ramunecyudokusha/ARSTM-2602/CYW43439KUBGT/SG-XFWLB-63-800.step

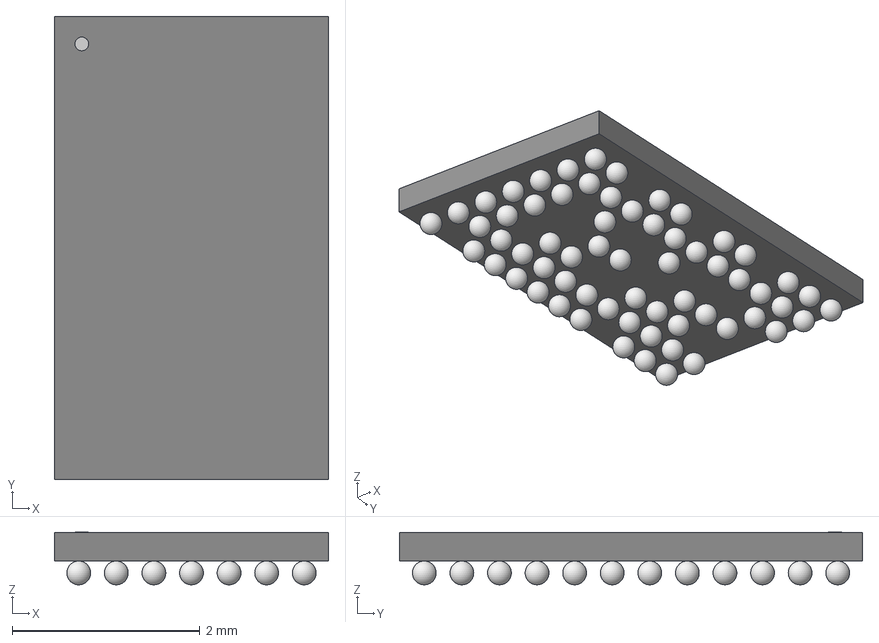
[picture p1: CAD file, 2026-05-24]
CYW43439KUBGT/SG-XFWLB-63-800.step
2.92 x 4.93 x 0.561 mm
