ramunecyudokusha/ARSTM-2602/kiban.step

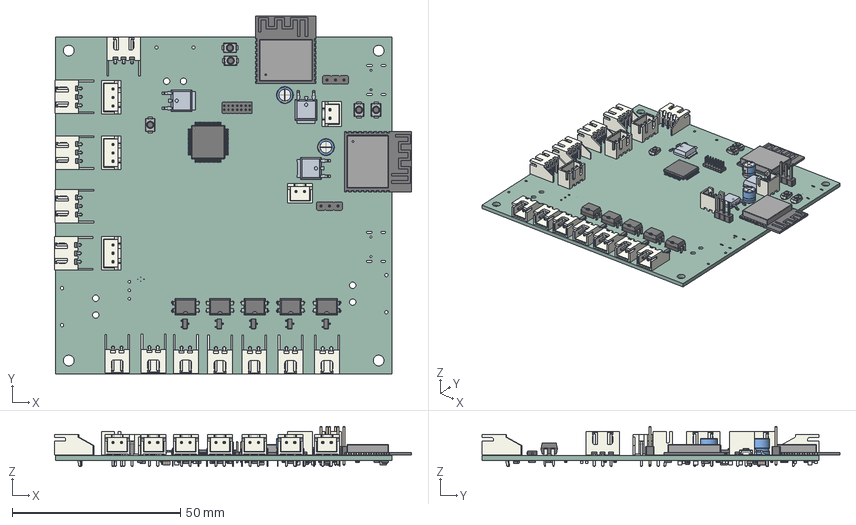
[picture p2: CAD file, 2026-08-06]
kiban.step
106.1 x 106.3 x 11.9 mm
JST_XH_S3B-XH-A-1_1x03_P2.50mm_Horizontal x 5
PinHeader_2x07_P1.27mm_Vertical
kiban 1.3.1 x 3
JST_XH_B3B-XH-A_1x03_P2.50mm_Vertical x 3
SW_Push_SPST_NO_Alps_SKRK x 5
CP_Radial_D5.0mm_P2.00mm x 2
JST_XH_B2B-XH-A_1x02_P2.50mm_Vertical x 2
SOT-23 x 5
DIP-4_W7.62mm x 5
ESP32-C3-WROOM-02 x 2
PinHeader_1x03_P2.54mm_Vertical x 2
JST_XH_S2B-XH-A-1_1x02_P2.50mm_Horizontal x 7
LQFP-64_10x10mm_P0.5mm
R_0603_1608Metric x 10
C_0603_1608Metric x 14
R_0805_2012Metric x 16
C_0805_2012Metric x 10
D_SOD-323F x 5
D_SOD-323 x 3
ARSTM2602_PCB
