ramunecyudokusha/ARSTM-2602/TCAN3414DRBR/TCAN3414DRBR.step

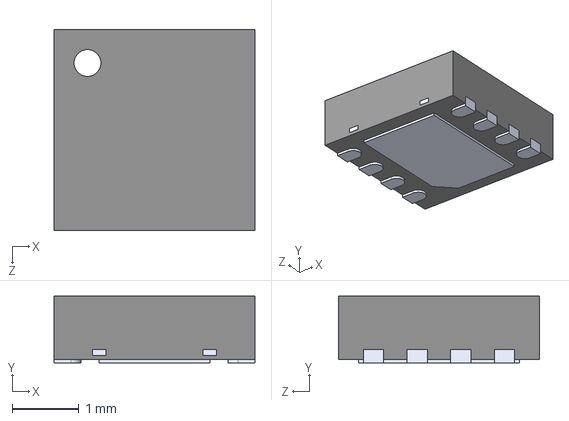
[picture p3: CAD file, 2026-05-17]
TCAN3414DRBR/TCAN3414DRBR.step
3.00 x 1.00 x 3.00 mm
