ramunecyudokusha/ARSTM-2602/(commit log)

2026-04-26 start project
    [ARSTM2602.kicad_pcb, ARSTM2602.kicad_sch]
2026-05-07 aaa
    gitdesktop test
    [ARSTM2602.kicad_sch]
2026-05-08 回路図を書き換えた
    マイコンを載せ替えただけ
2026-05-11 回路図をこぴった
    [ARSTM2602.kicad_sch]
2026-05-12 canモジュールを増やした
    電源供給方法をいろいろ考えついたから頑張る()
    [ARSTM2602.kicad_sch]
2026-05-17 canモジュールの置き換え
    tcan3414に置き換えた
    [ARSTM2602.kicad_sch, TCAN3414DRBR.step]
2026-05-24 サブマイコンx2を配置
    ESPとラズパイを置いた
    ラズパイはまだ途中
    [ARSTM2602.kicad_pcb, ARSTM2602.kicad_sch, SG-XFWLB-63-800.step, sub_esp.kicad_sch, sub_raspi.kicad_sch]
2026-06-16 一部回路図変更と部品配置
    [ARSTM2602.kicad_pcb, ARSTM2602.kicad_sch, sub_esp.kicad_sch]
2026-06-21 電磁弁用回路の増設
    [ARSTM2602.kicad_pcb, ARSTM2602.kicad_sch]
2026-06-25 完成(電磁弁制御,モーター出力追加済み)
    [ARSTM2602.kicad_pcb, ARSTM2602.kicad_sch, arstm2602_bom.csv, arstm2602_designators.csv, arstm2602_positions.csv, solenoid_valve.kicad_sch, sub_esp.kicad_sch, sub_raspi.kicad_sch]
2026-06-28 サーボときんていをつけ忘れていたので回路図に追加(部品配置に悩んでる
    [ARSTM2602.kicad_pcb, ARSTM2602.kicad_sch, solenoid_valve.kicad_sch, sub_esp.kicad_sch, tcan.kicad_sch]
2026-06-29 サーボ系ときんてい系の部品の配置と配線
    [ARSTM2602.kicad_pcb, ARSTM2602.kicad_sch, sub_esp.kicad_sch]
2026-08-06 完成版を上げ忘れていた
    [ARSTM2602.kicad_pcb, arstm2602_bom.csv, arstm2602_designators.csv, arstm2602_positions.csv, kiban.step]
